mattwilliamson/yamato/cad/yamato/yamato.sch

## EAGLE design cad/yamato/yamato.sch (2014-02-10)

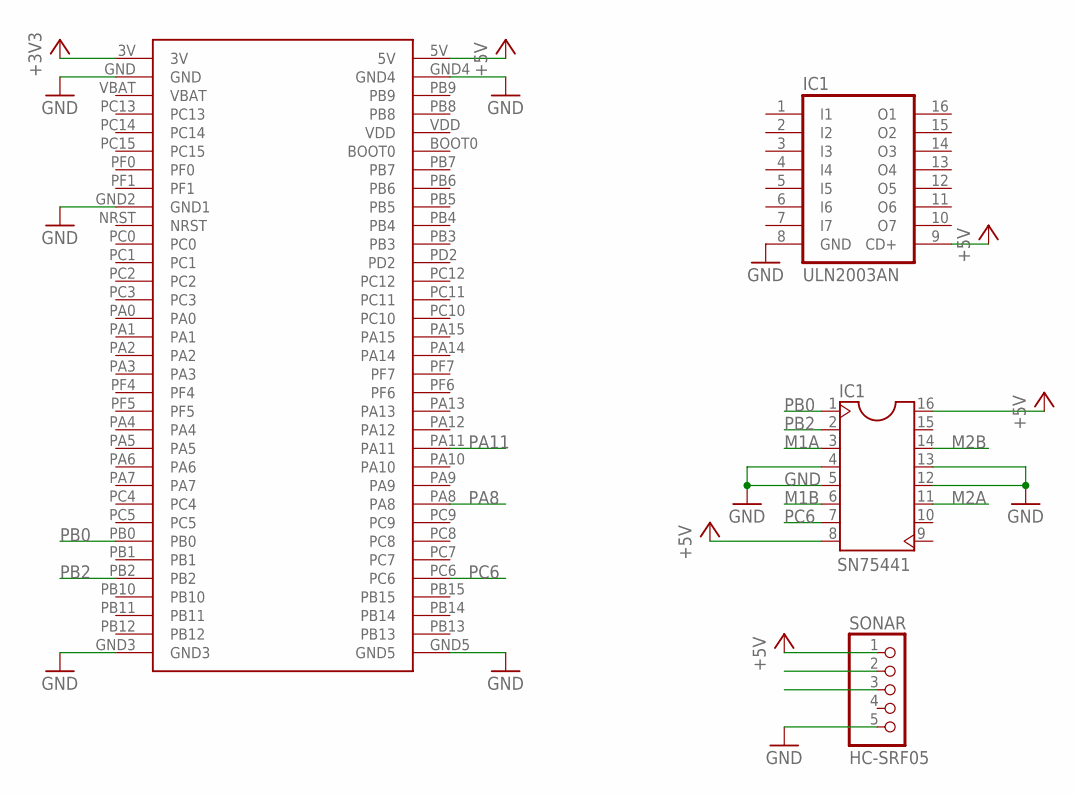
[picture p1: schematic yamato.sch]

Parts:
IC1: ULN2003AN; DIL16
SONAR: HC-SRF05; 1X05
U$1: STM32F0DISCOVERY-DEVICE; STM32F0DISCOVERY-PACKAGE
U$2: SN75441-DEVICESN75411-SOCKET; SOCKET-16

Connections:
+3V3: U$1.3V
+5V: IC1.9 (CD+), SONAR.1, U$1.5V, U$2.8 (VCC2), U$2.16 (VCC1)
GND: IC1.8 (GND), SONAR.5, U$1.GND, U$1.GND2 (GND1), U$1.GND3, U$1.GND4, U$1.GND5, U$2.4 (GND), U$2.5 (GND1), U$2.12 (GND2), U$2.13 (GND3)
M1A: U$2.3 (1Y)
M1B: U$2.6 (2Y)
M2A: U$2.11 (3Y)
M2B: U$2.14 (4Y)
PA8: SONAR.3, U$1.PA8
PA11: SONAR.2, U$1.PA11
PB0: U$1.PB0, U$2.1 (12EN)
PB2: U$1.PB2, U$2.2 (1A)
PC6: U$1.PC6, U$2.7 (2A)
