mattwilliamson/yamato/src/telemetry.h

#pragma once

#include "yamato.h"

#include <string.h>
#include <stdlib.h>
#include <time.h>

#include "shell.h"
#include "chprintf.h"
#include "chrtclib.h"

#include "sonar.h"
#include "motors.h"
#include "line.h"
#include "ir.h"

void telemetryInit(void);
