mattwilliamson/yamato/(commit log)

2014-02-10 Remove dynamic threads
    [yamato.sch]
2014-02-12 Moved IR into the motor PWM
2014-02-16 Refactored sensors to use events and decouple mission logic from main loop
2014-02-18 Added pin list
2014-02-20 Checkpoint while debugging IR Sensor events
